hardenxiao2-maker/MSPM0-Gimbal-Adaptive-Tracker/(list of files, drawings)

Other design files:
ProPrj_电赛MSPM0公507扩展板_2026-05-01.epro
